BinhKien/SMART-MUSHROOM-PROJECT/README.md

https://youtu.be/pcl6sfKhQQs?si=KjfYiF2nglYFyfDk
