BinhKien/SMART-MUSHROOM-PROJECT/(list of files, drawings)

Other design files:
SIMULATION.pdsprj
